MateoSte/WRO2026FE_ControlledCHAOS/imgs/Image_OpenMV.png

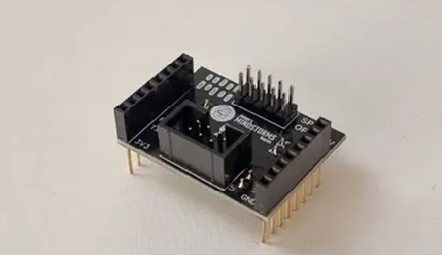
imgs/Image_OpenMV.png
