MateoSte/WRO2026FE_ControlledCHAOS/imgs/spike_prime_hardware_architecture.png

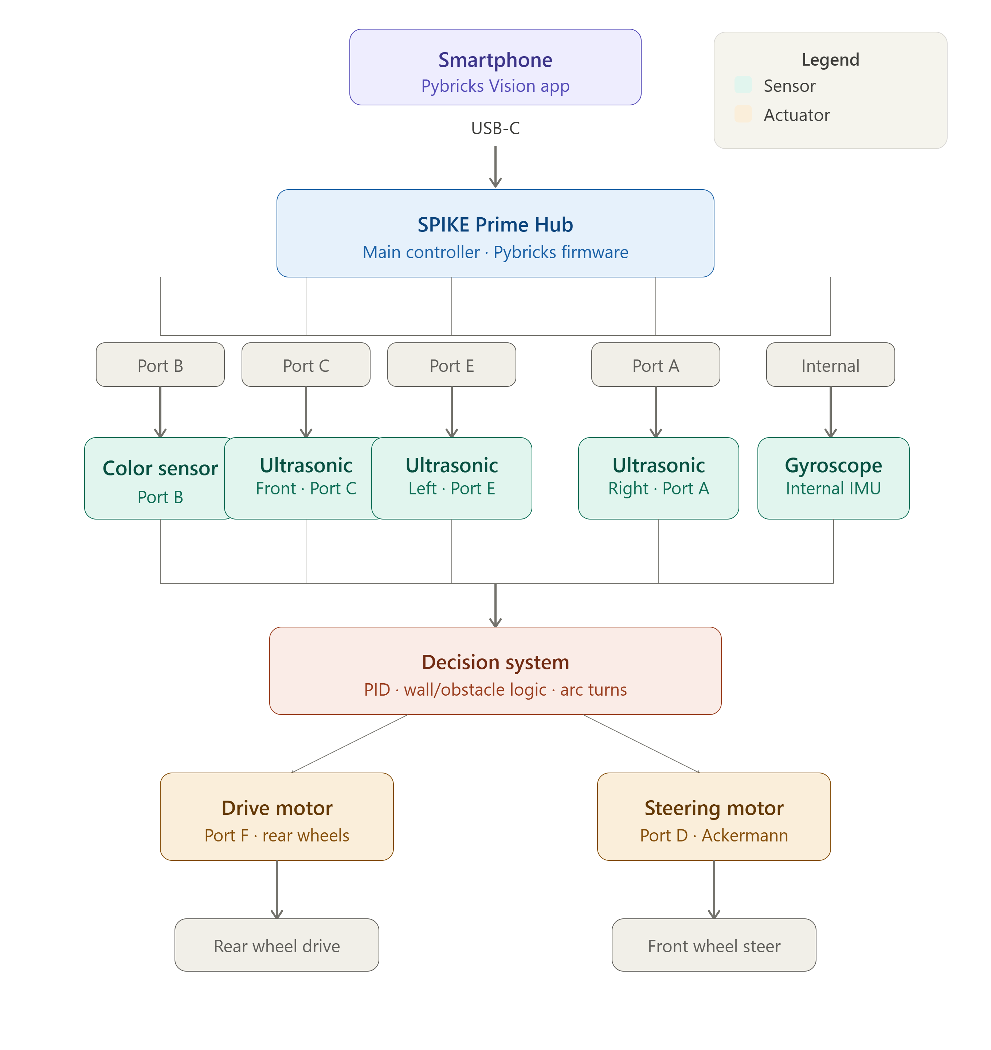
imgs/spike_prime_hardware_architecture.png
