MateoSte/WRO2026FE_ControlledCHAOS/WRO_connection_map.png

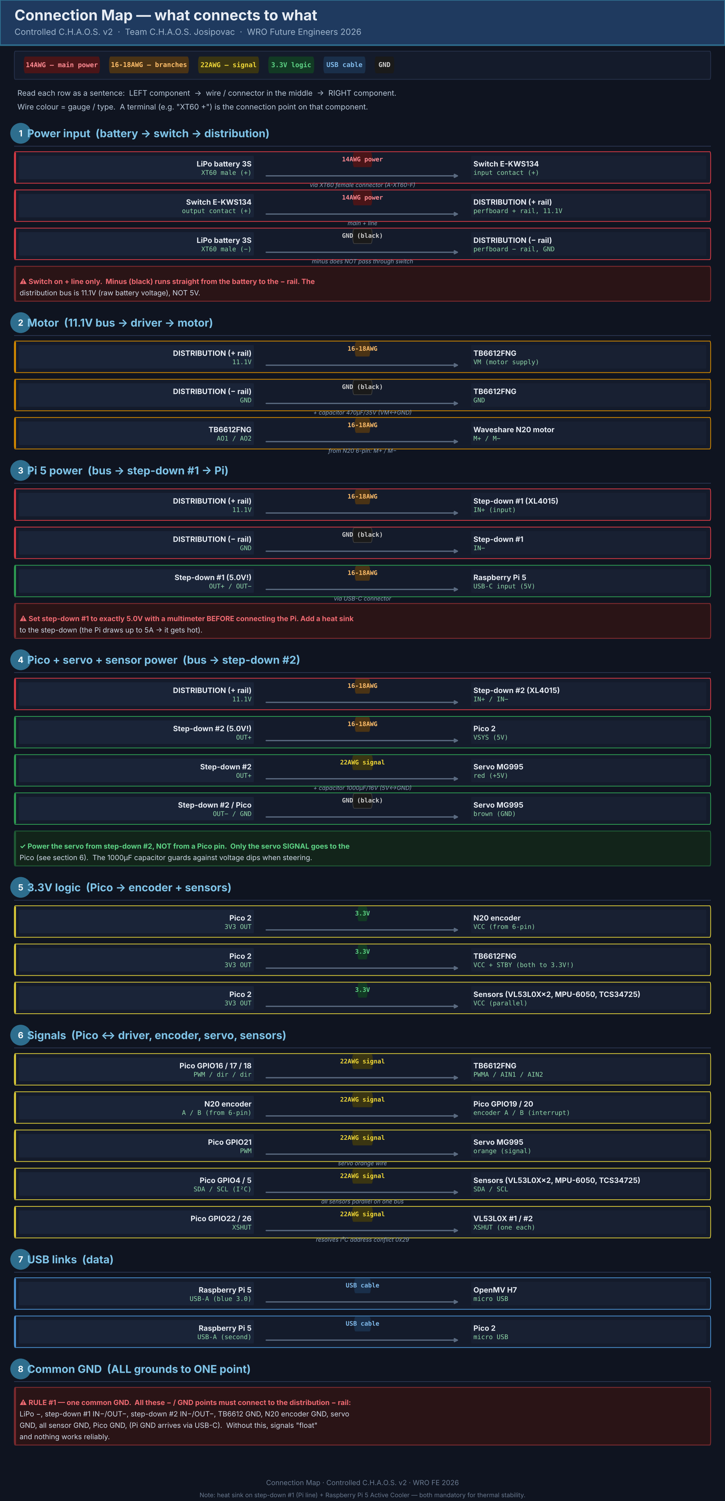
WRO_connection_map.png
