MateoSte/WRO2026FE_ControlledCHAOS/build_GPIO_pin_assignment_v1.png

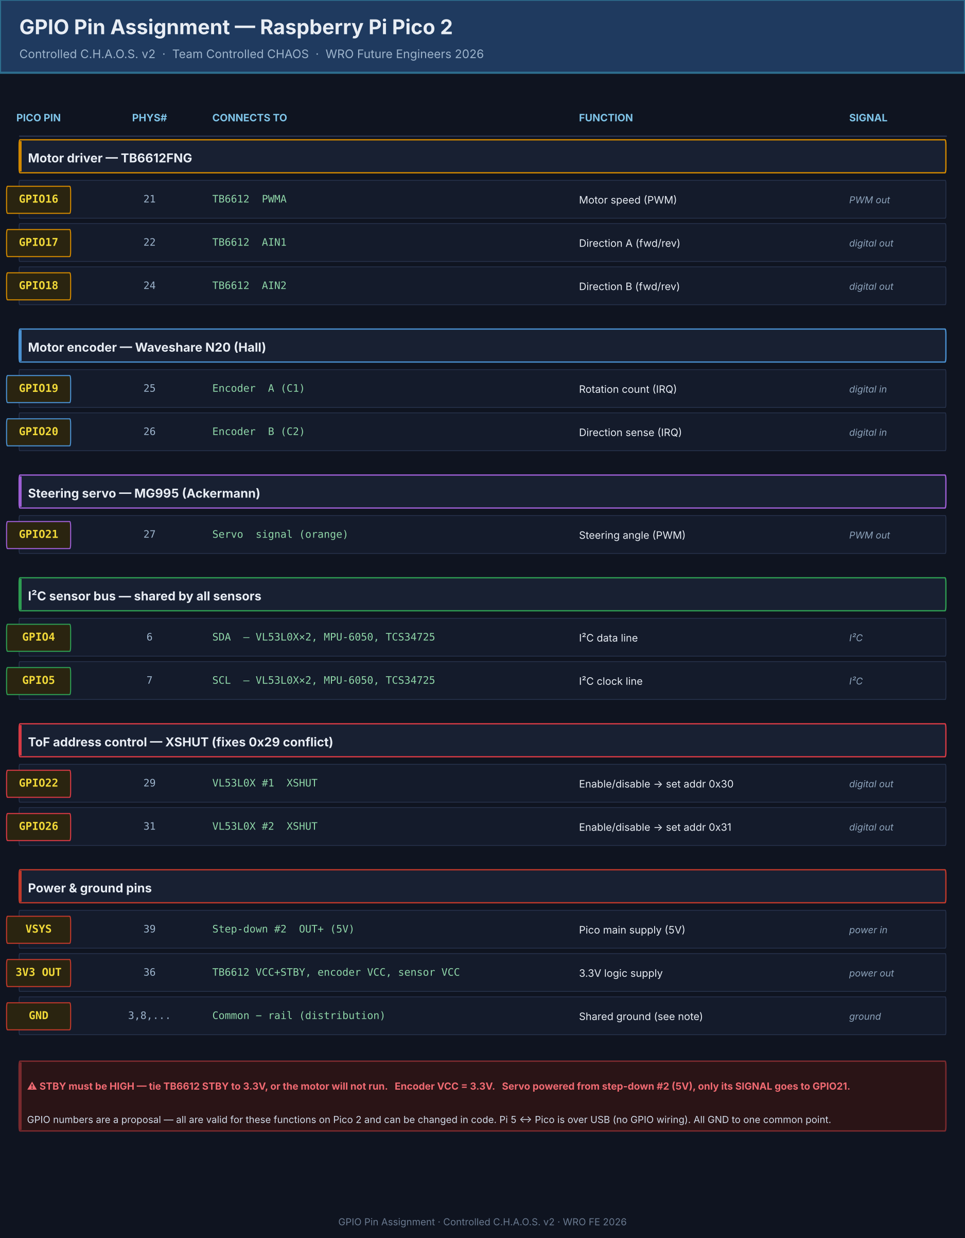
build_GPIO_pin_assignment_v1.png
