MateoSte/WRO2026FE_ControlledCHAOS/(commit log)

2026-06-14 camera test
2026-06-15 New copy of Open challenge to fix turn_radius function
    [COPY_WRO26_1zad_fixTurnRadius.py]
2026-06-17 switch from 2 color sensors to only 1
2026-06-19 Fix Open and redo Obstacle challange with a copy
    [WRO_2026_1zadatak_betaPY.py, new_zad2_BruteForce.py]
2026-06-19 Add OpenMV camera files in folder and new README
2026-10-08 Switch from pybricks to C++ and arduino
2026-10-09 Add code to fetch gyro heading. Testing is needed.
